tgd1975/tinyjukebox/src/tinyjukebox/web/web/help/images/box-back.jpg

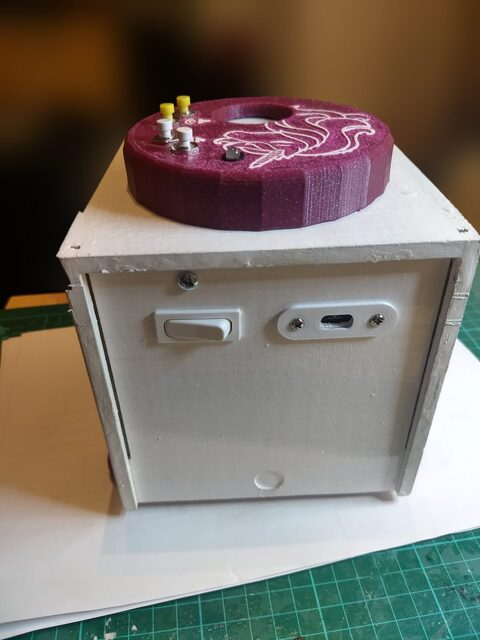
src/tinyjukebox/web/web/help/images/box-back.jpg
