tgd1975/tinyjukebox/hardware/3d-parts/figure_base_cup.png

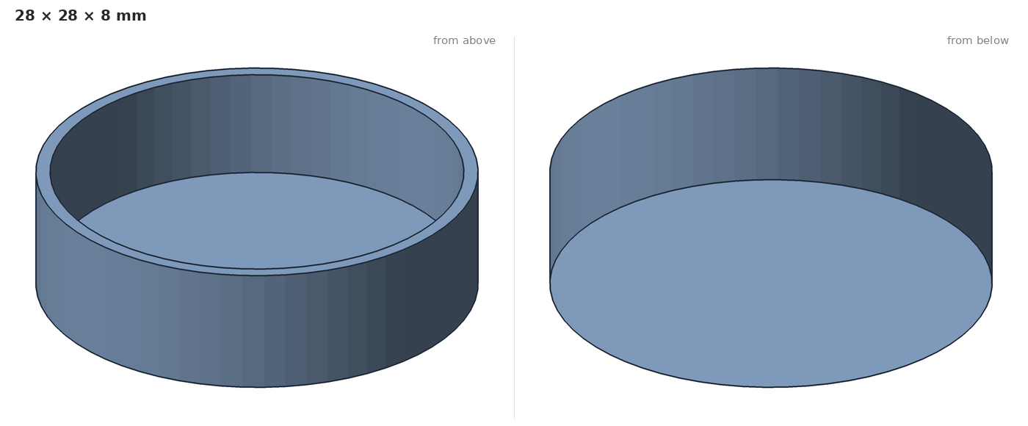
hardware/3d-parts/figure_base_cup.png
