tgd1975/tinyjukebox/hardware/3d-parts/figure_base_wide_plug.png

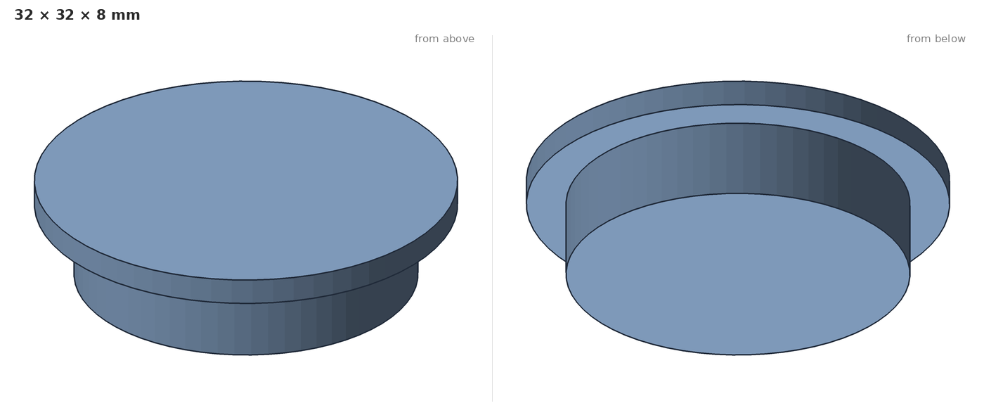
hardware/3d-parts/figure_base_wide_plug.png
