tgd1975/tinyjukebox/hardware/3d-parts/foot.png

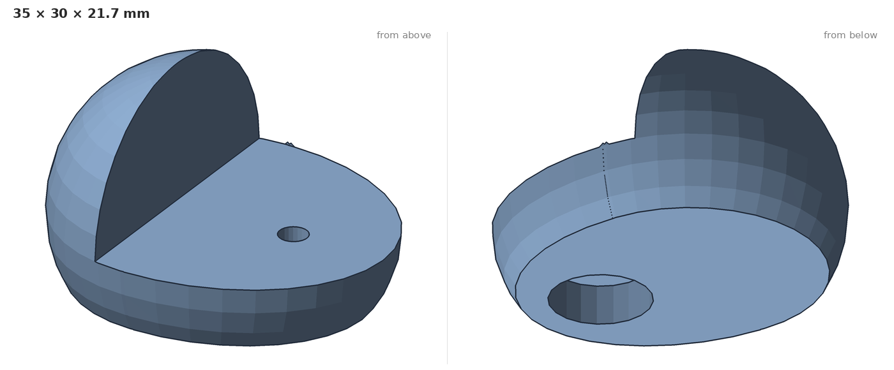
hardware/3d-parts/foot.png
