tgd1975/tinyjukebox/hardware/3d-parts/front_grille.png

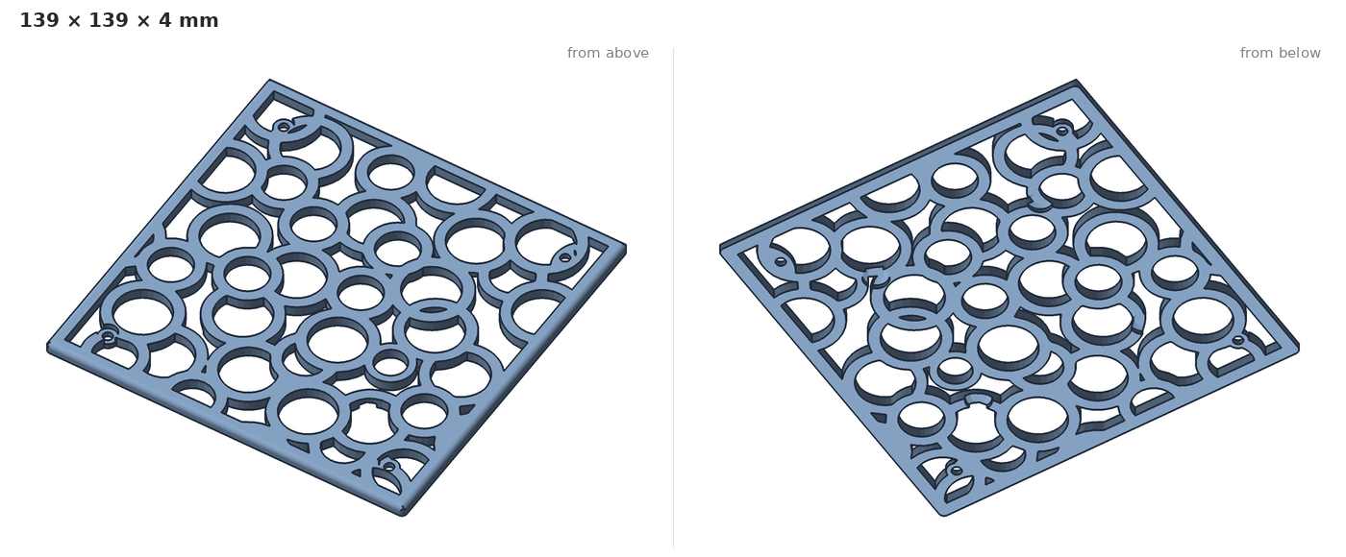
hardware/3d-parts/front_grille.png
