tgd1975/tinyjukebox/hardware/3d-parts/lid.png

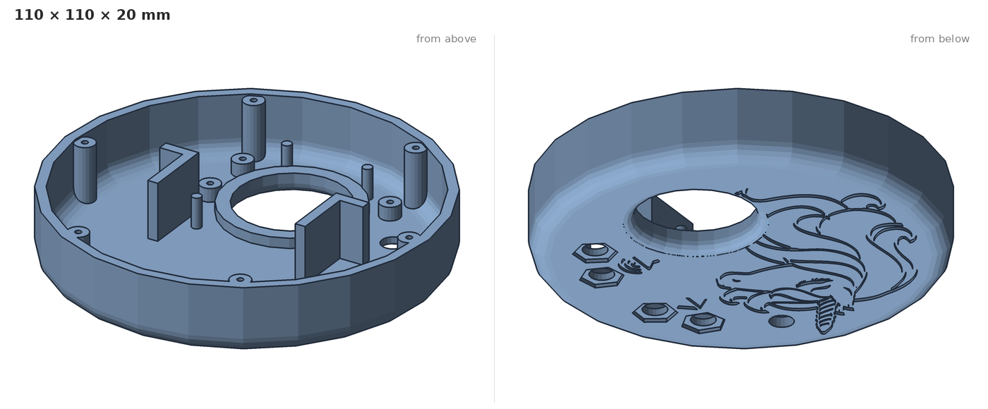
hardware/3d-parts/lid.png
