tgd1975/tinyjukebox/hardware/3d-parts/lid_inlay.png

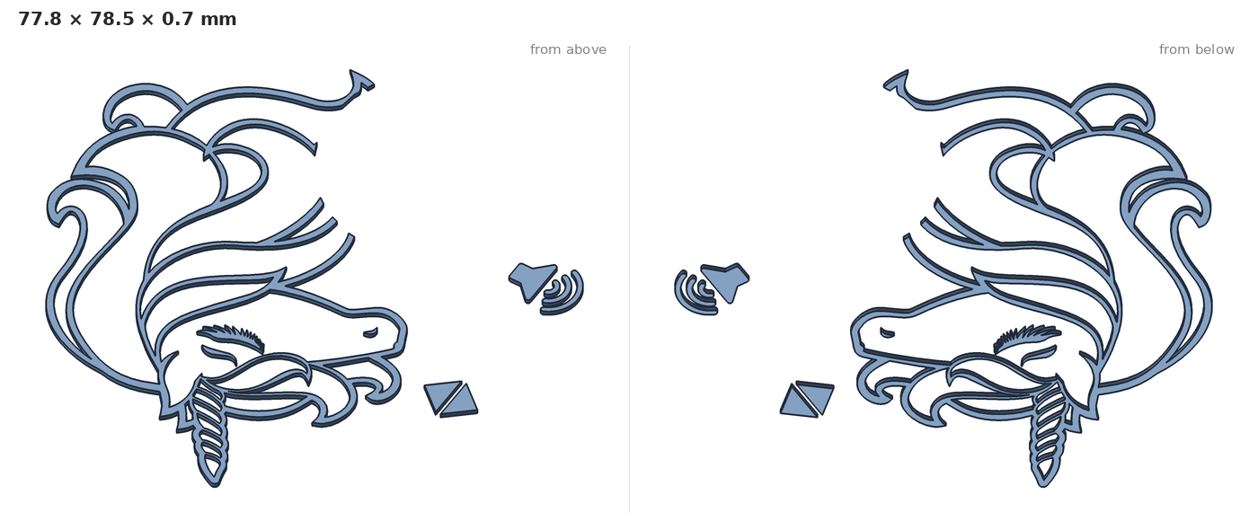
hardware/3d-parts/lid_inlay.png
