tgd1975/tinyjukebox/hardware/3d-parts/lock_screw_bracket.png

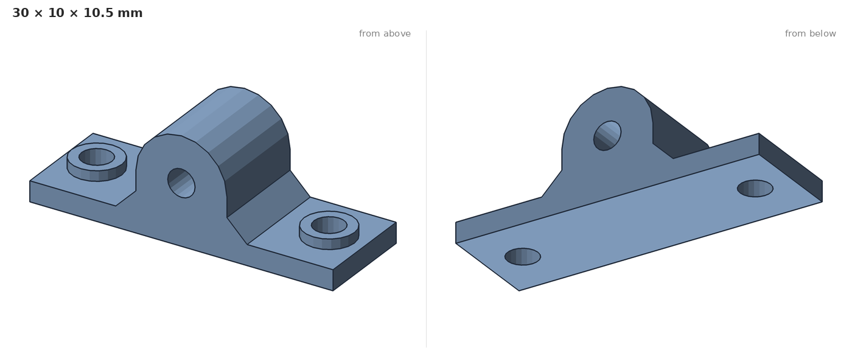
hardware/3d-parts/lock_screw_bracket.png
