tgd1975/tinyjukebox/hardware/3d-parts/power_bank_mount.png

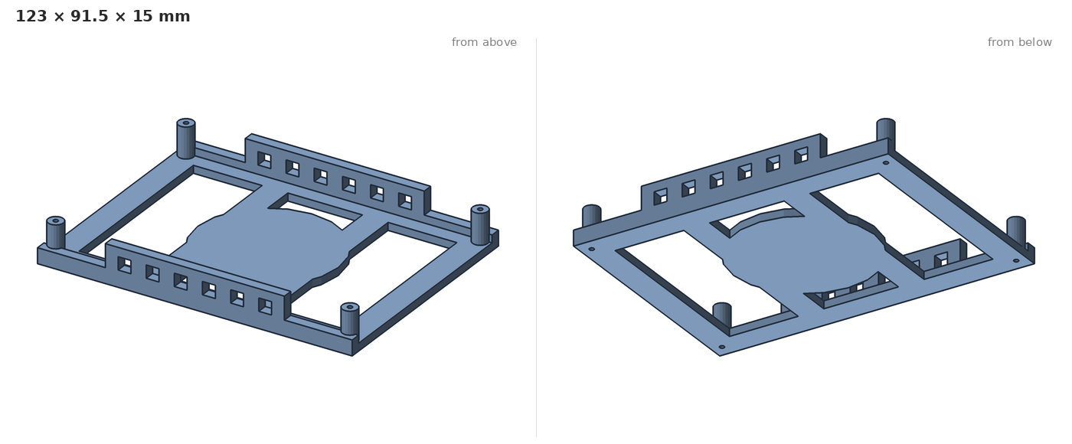
hardware/3d-parts/power_bank_mount.png
