tgd1975/tinyjukebox/hardware/3d-parts/rfid_reader_holder.png

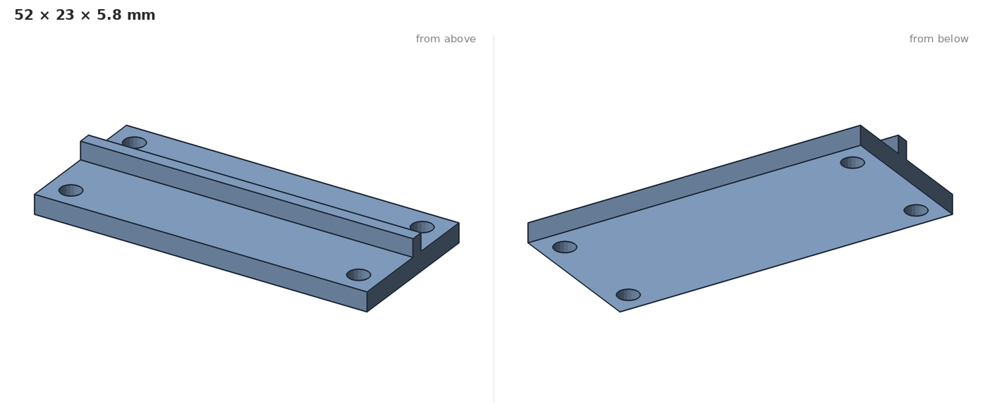
hardware/3d-parts/rfid_reader_holder.png
