tgd1975/tinyjukebox/hardware/3d-parts/spacer_3mm.png

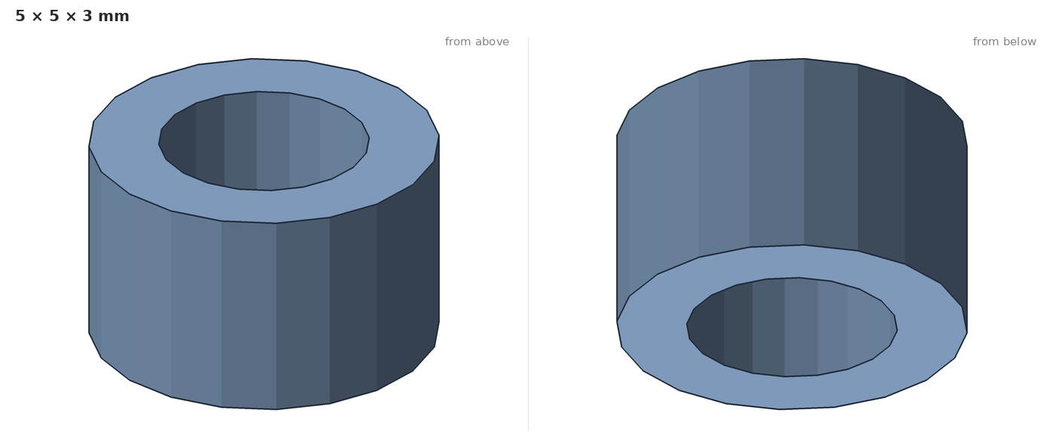
hardware/3d-parts/spacer_3mm.png
