tgd1975/tinyjukebox/hardware/3d-parts/usb_port_bezel.png

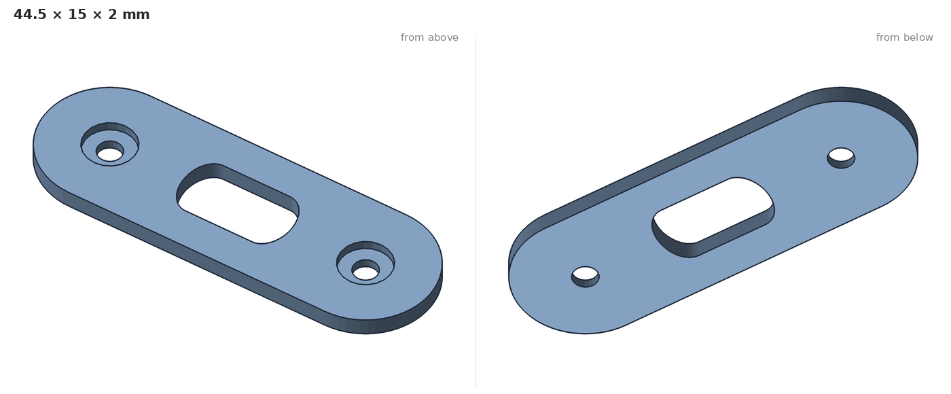
hardware/3d-parts/usb_port_bezel.png
