tgd1975/tinyjukebox/hardware/3d-parts/front_panel.stl

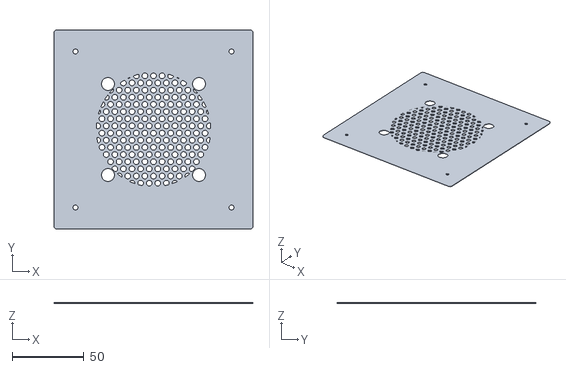
[picture p28: CAD file, 2026-10-13]
hardware/3d-parts/front_panel.stl
139.0 x 139.0 x 1.00
