tgd1975/tinyjukebox/hardware/3d-parts/rfid_reader_holder.stl

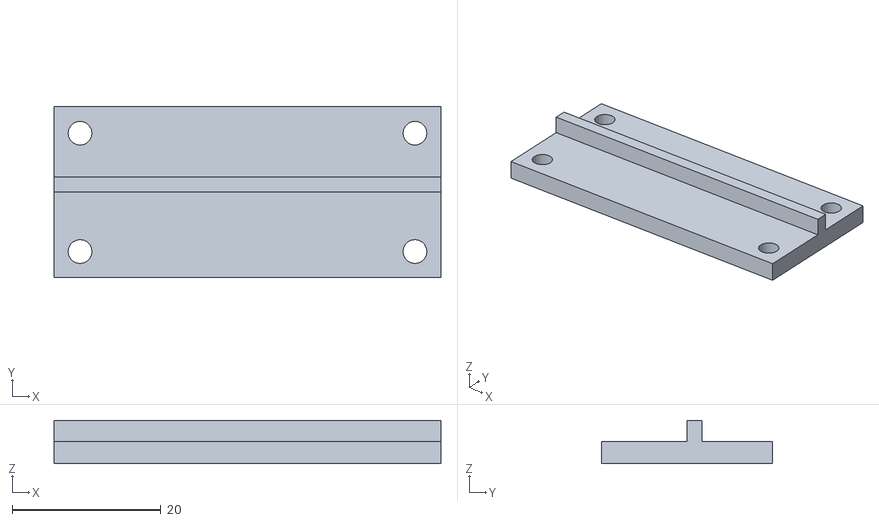
[picture p29: CAD file, 2026-10-13]
hardware/3d-parts/rfid_reader_holder.stl
52.0 x 23.0 x 5.80
