tgd1975/tinyjukebox/hardware/3d-parts/figure_base_wide_cup.stl

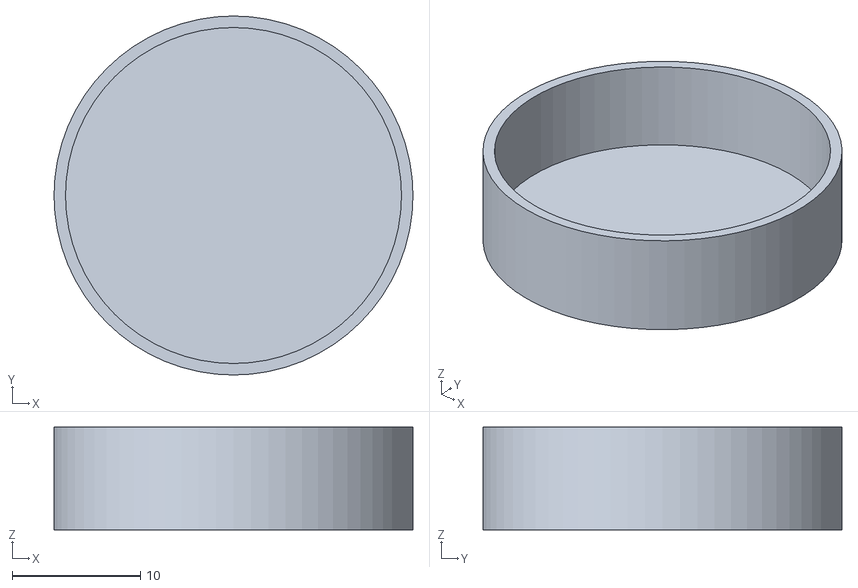
[picture p30: CAD file, 2026-10-13]
hardware/3d-parts/figure_base_wide_cup.stl
28.0 x 28.0 x 8.00
