tgd1975/tinyjukebox/hardware/3d-parts/usb_port_bezel.stl

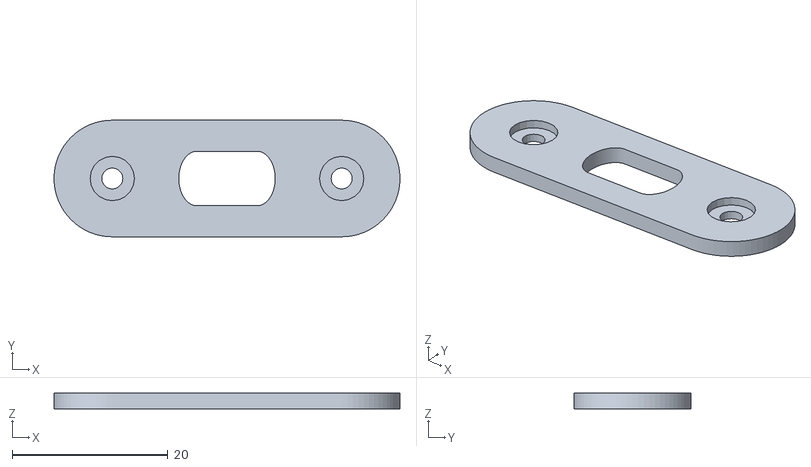
[picture p31: CAD file, 2026-10-13]
hardware/3d-parts/usb_port_bezel.stl
44.5 x 15.0 x 2.00
