tgd1975/tinyjukebox/hardware/3d-parts/front_grille.stl

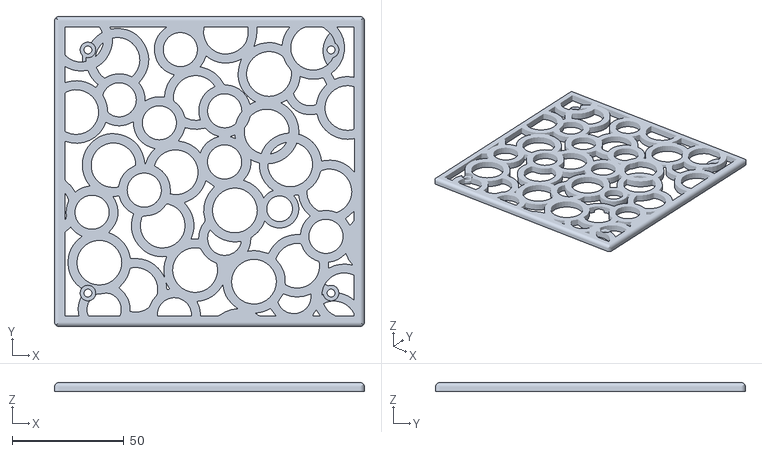
[picture p32: CAD file, 2026-10-13]
hardware/3d-parts/front_grille.stl
139.0 x 139.0 x 4.00
