tgd1975/tinyjukebox/hardware/3d-parts/power_bank_mount.stl

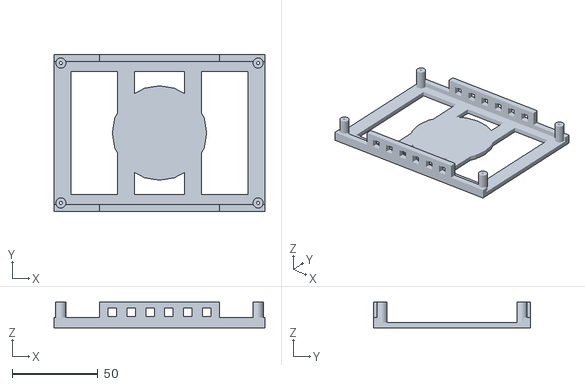
[picture p33: CAD file, 2026-10-13]
hardware/3d-parts/power_bank_mount.stl
123.0 x 91.5 x 15.0
