tgd1975/tinyjukebox/hardware/3d-parts/lid.stl

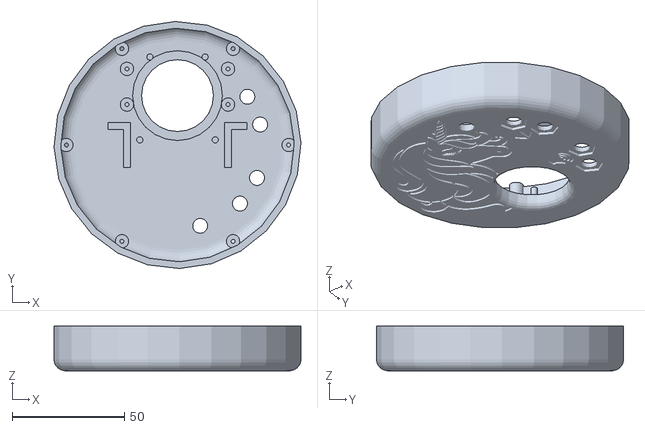
[picture p34: CAD file, 2026-10-13]
hardware/3d-parts/lid.stl
110.0 x 110.0 x 20.0
