tgd1975/tinyjukebox/hardware/3d-parts/figure_base_wide_plug.stl

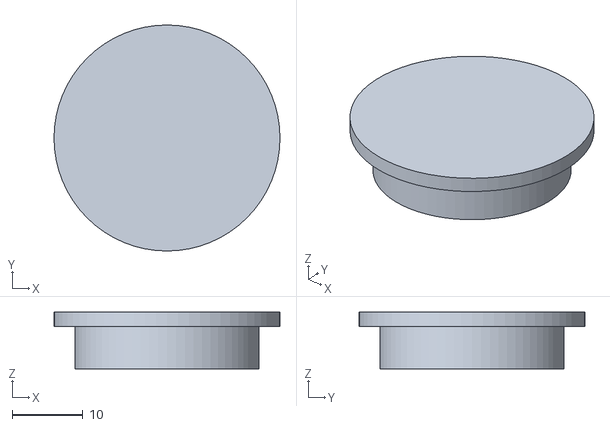
[picture p35: CAD file, 2026-10-13]
hardware/3d-parts/figure_base_wide_plug.stl
32.0 x 32.0 x 8.00
