tgd1975/tinyjukebox/hardware/3d-parts/lid_inlay.stl

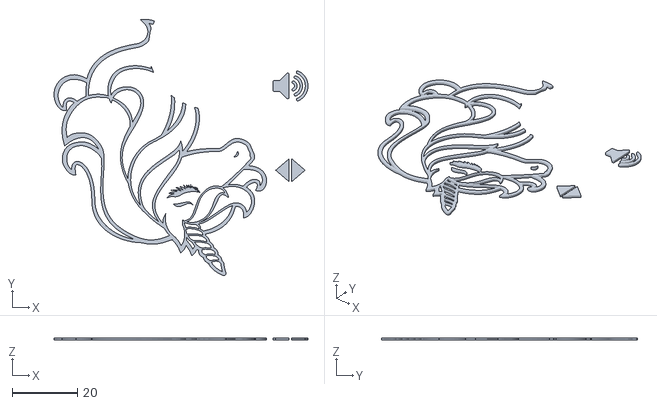
[picture p36: CAD file, 2026-10-13]
hardware/3d-parts/lid_inlay.stl
77.8 x 78.5 x 0.7
