tgd1975/tinyjukebox/hardware/3d-parts/spacer_3mm.stl

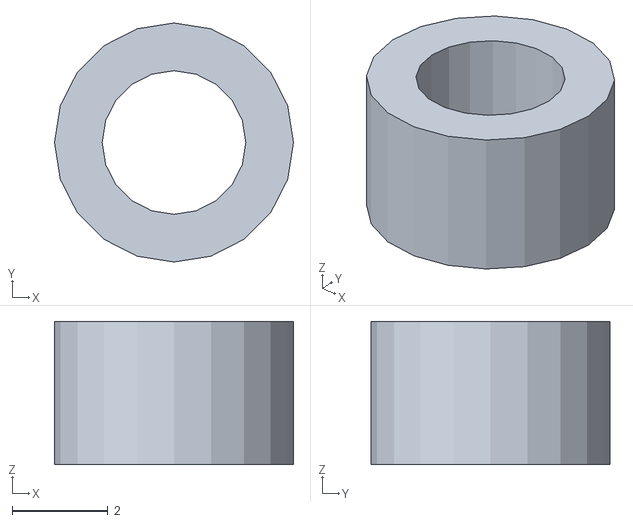
[picture p37: CAD file, 2026-10-13]
hardware/3d-parts/spacer_3mm.stl
5.00 x 5.00 x 3.00
