tgd1975/tinyjukebox/hardware/3d-parts/figure_base_plug.stl

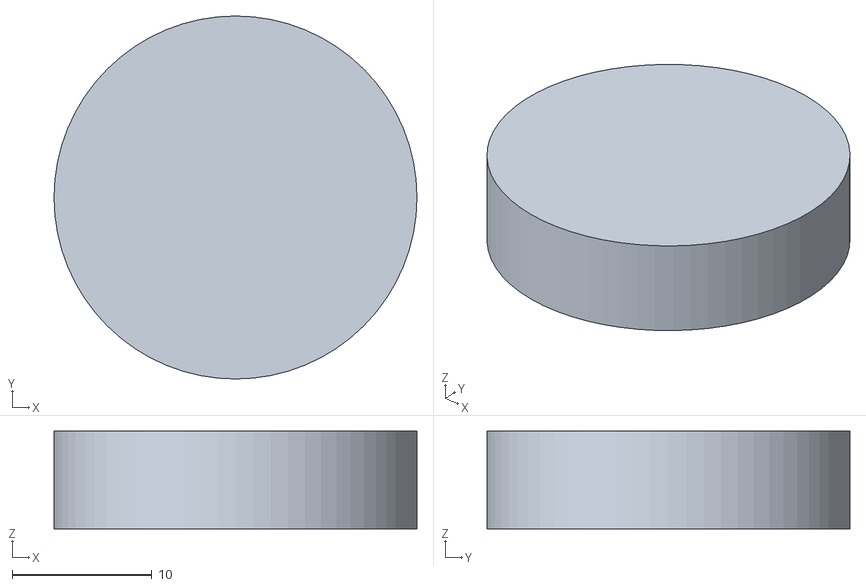
[picture p38: CAD file, 2026-10-13]
hardware/3d-parts/figure_base_plug.stl
26.0 x 26.0 x 7.00
