tgd1975/tinyjukebox/hardware/3d-parts/foot.stl

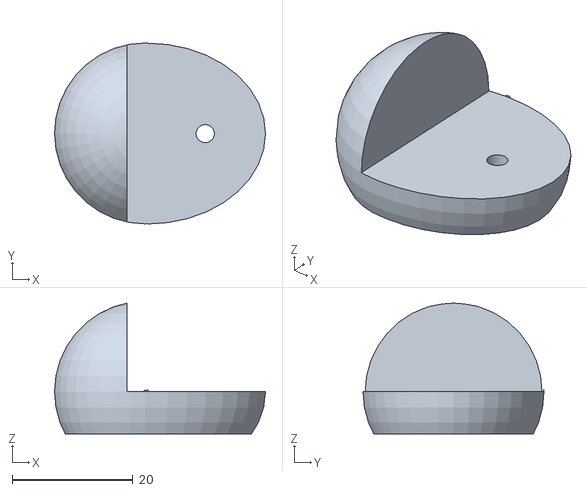
[picture p39: CAD file, 2026-10-13]
hardware/3d-parts/foot.stl
35.0 x 30.0 x 21.7
