tgd1975/tinyjukebox/hardware/3d-parts/lock_screw_bracket.stl

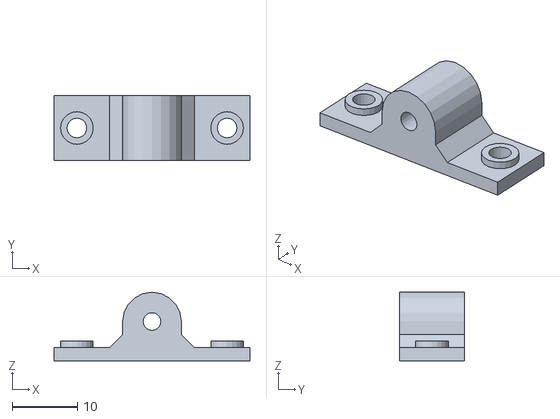
[picture p40: CAD file, 2026-10-13]
hardware/3d-parts/lock_screw_bracket.stl
30.0 x 10.0 x 10.5
