tgd1975/tinyjukebox/(list of files, cad)

Other CAD files:
hardware/3d-parts/figure_base_cup.stl
