tgd1975/tinyjukebox/docs/user/de/quick-guide.md

# Tiny Jukebox – Kurzanleitung

Tiny Jukebox

<!-- Textvorlage für eine Karte im Format A6 (wie die Tag-Karten), Vorder- und Rückseite.
     Bilder und Layout kommen dazu – der Text bleibt deshalb knapp. Ausführlich: manual.md -->

## 1. Vorderseite: Hören

### 1.1 Tag

- auflegen: Album spielt dort weiter, wo es aufgehört hat
- abnehmen: Stopp

### 1.2 Tasten

- lauter / leiser – halten: feine Schritte
- weiter: nächster Titel
- zurück: Titelanfang – in den ersten 10 s: voriger Titel
- zurück 1 s halten: Album von vorn

### 1.3 Licht

- grün: bereit
- blau: spielt – blinkt: Album zu Ende
- weiß/blau: Pause
- grün → türkis → blau: holt das Album, oder das Radio startet
- gelb: Tag ohne Album
- rot blinkend: Album defekt

### 1.4 Kopfhörer

- koppeln: Kopfhörer in den Pairing-Modus, dann weiter + zurück 5 s halten – blinkt blau, weiß = fertig
- danach: Kopfhörer einschalten genügt, Ton nur im Kopfhörer
- Kopfhörer aus: Pause – weiter drücken: Lautsprecher

### 1.5 Aus

- mit dem Schalter auf der Rückseite

### 1.6 Telefon (App)

- Tag an die Rückseite des Telefons: spielt wie auf der Box – oder eine Kachel antippen
- dasselbe Licht als Band oben am Bildschirm

## 2. Rückseite: Webseite

### 2.1 <https://tinyjukebox.local>

- im selben WLAN öffnen, Sicherheitswarnung bestätigen, „Deutsch“ wählen, anmelden

### 2.2 Tabs

- **Jetzt:** was läuft, Pause, Titel, Lautstärke
- **Tags:** Tag per Klick auflegen
- **Hochladen:** Titel des Albums eingeben, MP3-Dateien wählen → „Album anlegen“
- **Neuer Tag:** auflegen → „Jetzt“ → Album wählen → „Verknüpfen & abspielen“
- **Radio:** Sender anlegen, unter „Tag-Verwaltung“ einem Tag zuordnen
- **Spotify:** Link aus der Spotify-App einfügen, unter „Tag-Verwaltung“ einem Tag zuordnen
- **Bluetooth:** Kopfhörer koppeln, Akku, Höchstlautstärke
- **System:** Passwort, Benutzer, Bibliothek, Version
