tgd1975/tinyjukebox/(list of files, drawings)

Other design files:
hardware/circuits/tinyjukebox.fzz
