tgd1975/tinyjukebox/(commit log)

2026-10-13 Tiny Jukebox 0.30.0
    RFID-controlled music box for children: the software of the box and of the library, the playbook, the package for
    the NAS, the documentation and the hardware. CHANGELOG.md tells the history of the project up to this version.
    [figure_base_cup.stl, figure_base_plug.stl, figure_base_wide_cup.stl, figure_base_wide_plug.stl, foot.stl, front_grille.stl, front_panel.stl, lid.stl]
2026-10-13 The playbook sets up a new box with slots (0.30.1) - the role tinyjukebox enabled the service before the role slots had written its unit: a box that never had the service stopped at "Service starts w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
2026-10-13 The page of a box shows its name with "Rename" next to it (0.30.2) - tab "System", section "Library": the name of the box with a button that asks for the new name, starting from the one the box has -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
2026-10-13 The page of a box shows what its hardware does (0.31.0) - tab "System", card "Hardware", for admins: level of the pin, last event and number of presses of every button, pattern and lit lights of the 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
2026-10-13 The concept for Spotify is decided: the box as a speaker without a tag, a daily look for a new build - the box asks Spotify every day whether the build has changed, the page shows state and age of th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
2026-10-14 The concept for Spotify after its review: a new build only 30 days before the last day, an account of its own per box - Spotify publishes builds several times a day: the box keeps the build it has un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
2026-10-14 The library says why a box went back from a version (0.31.1) - the box sends the reason of its last switch away from a version it left along (health check failed: ...), and the library logs it, keeps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
2026-10-14 Every backup holds the covers of the albums (0.32.0) - the cover of an album is an image of the images folder, album-<8 characters>.<type>, named by the album in targets.json (cover) - no file of the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
2026-10-14 A backup is put back on the page (0.35.0) - tab "System", card "Backup", on a box and on the library: an upload, or a backup of the table, is read to its end and unpacked beside the data, the page as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
2026-10-14 Entries of Spotify in the catalog (step 1 of the concept) - the kind "spotify" in targets.json and tags.json: name, address spotify:<kind>:<id> and cover; made from the link that the Spotify app shar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
2026-10-14 The account of Spotify on a box (step 2 of the concept) - the Soloist API key, the login and the switch of the speaker stay in the folder "spotify" of the box: not synchronized, not in a backup - the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
2026-10-14 The box plays entries of Spotify (step 3 of the concept) - a tag of an entry plays it with Soloist, like an album: it continues at the saved track - reached by its place and checked by its address, l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
2026-10-14 The statistics count entries of Spotify (step 4 of the concept) - an entry counts like an album: per tag, per day, played to its end; the skipped tracks of an entry are counted by their address and s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
2026-10-14 Spotify in the documents, the concept is done (0.37.0, step 5 of the concept) - manuals and quick guides (de, en): section 7.6 "Spotify", the tab "Spotify", the filter in "Tags" - architecture.md: Pl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
2026-10-15 A new version is no longer sent back right after the box was switched on (0.36.1) - the start script counted the 120 s of stage 1 on the clock of the system, which jumps forward by hours when the Pi 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
2026-10-15 The box may restart its service without a password (0.36.1) - the slot scripts restart it with sudo systemctl restart tinyjukebox as the user of the box after a switch; the playbook allows this one c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
2026-10-15 The volume buttons keep working after a step that failed (0.36.2) - an exception while the volume was set left the state machine in the state of that step, which takes no button, until the next start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
2026-10-15 The concept for installing without the repository is reviewed against 0.37.1 and reworked - the installer does all that the playbook does today for a box with slots: also the packages for Spotify wit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
2026-10-16 A trigger file is obeyed once, and Spotify can be connected, on a box whose user needs a password for sudo (0.37.2) - the start script removes a trigger file on the boot partition with sudo as the us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
2026-10-16 The installer of a box, and the playbook runs it (steps 1 and 2 of the distribution concept) - deploy/install/install.sh sets up a fresh Raspberry Pi OS Lite: packages (with those for Spotify), group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
2026-10-16 The library hands out the installer and a new box joins it with one line (step 3 of the distribution concept) - the library fetches install.sh with every release (tinyjukebox-install-<version>.sh in 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
2026-10-16 Library and box start with nothing but a folder (step 4 of the distribution concept) - tinyjukebox-library --data DIR and tinyjukebox --data DIR: everything below the folder, in the folders library a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
2026-10-16 The Docker image and PyPI (steps 5 and 6 of the distribution concept) - deploy/docker: one image for the library (default) and a box without hardware (command box), built from the wheel of the build,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
2026-10-16 The installer passes on the stand-in for a box - deploy/install/test/run.sh: the stand-in has the package source of Raspberry Pi OS (liblgpio1 is only there; its key from raspberrypi-archive-keyring,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
2026-10-16 Keep the wires from the lid away from the magnet ring of the speaker - hardware/README.md, section Wiring
2026-10-16 Photos of the box and a logo in the documents - docs/images/ holds photos of the first box (December 2019) and of the box today, the Tinkercad model and the logo as SVG
    - README: the logo in place of the title, light or dark by the mode of the page; the box today under the first
    paragraph; in "History" the first box of 2019 and the inside then and now
    - hardware/README.md: the model at the top, the wired lid next to the circuit, the bare case above the printed parts,
    a photo for each printed part that has one
    - box.md: the inside today in section 1; in section 11 the connectors secured on the pins of the Pi
    - docs/hardware/README.md: the Pi with the Audio Amp SHIM
    - manual (English and G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
2026-10-19 Recovery concept: power cut is how the box is switched off; cause of the journal damage
2026-10-19 Box config: 2 s aplay buffer against radio pauses on WLAN with power saving
2026-10-19 Fallback slot is recovery mode: install a version instead of an old application
    The start script no longer starts the application of the fallback slot,
    which could not read the data of today. It installs the newest version the
    box has not gone back from and restarts into it; without one it waits and
    asks again every 10 minutes, without a restart loop. With updates by hand
    or off it waits for an administrator. The page button becomes "Start
    emergency mode"; texts for the data left out.
2026-10-19 Release 0.40.0: recovery mode and tolerant data, documented
    Section 4.21 (damaged and unknown data), journal marks in section 7, the
    fallback slot as recovery mode in section 6.10, user manuals. The recovery
    concept is implemented and removed.
2026-10-19 Central diagnostics: the library keeps what the boxes log
    A log handler collects warnings, errors and marked structured events,
    redacted and bounded, and the synchronization delivers them; the library
    keeps them in diagnostics.sqlite with retention and shows them in its Log
    tab with filters, copy and export. A box that cannot start reports why
    through its start script over the stable PUT /api/sync/startup. Radio
    connections are measured phase by phase (playlist, ffmpeg and aplay, first
    audio, estimated audible start, underruns).
2026-10-19 App, step 0: the probe - how a tag behaves on a phone
    A throw-away app (app/probe/, not released) with one screen and a log, no library, no sound: the UID in the form of
    rfid-reader and when a tag is found, how long it is kept, how late a removal is reported - NfcAdapter.ignore()
    against asking the tag every 250 ms, switched with a button -, what happens when the screen goes off and on or the
    app leaves the screen, the battery every minute while the screen is kept on and dimmed after 30 s. The log is shared
    as text. Built with ./gradlew -p app :probe:assembleDebug, installed with adb install.
2026-10-19 App, steps 3 and 4: simple mode plays, expert mode shows the page
    Simple mode (the phone as a box):
    - pairing with the camera (ZXing, no services of Google needed); a debug build also takes the content of the QR
    code from the intent, for the emulator
    - the jukebox: the states of STMOperation that apply, the band of colour as the LED of the box; a tag plays its
    album from the saved position or its station, another tag replaces it, taken away the position is saved, an album
    played to its end blinks blue and starts from the beginning next time, an unknown tag is looked up and reported
    not linked, an album that is not in the cache is loaded, a missing next track is waited for
    - Media3/Ex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
2026-10-19 App, step 5: delivery - the APK in every release, the library hands it out at /app.apk
    - scripts/build_app.sh builds dist/tinyjukebox-app-<version>.apk, signed with APP_SIGNING_KEY (keystore in Base64)
    and APP_SIGNING_PASSWORD; without them with the debug key. build.sh runs it, the release job sets up Java and
    needs the job "app"; app/ counts as software in release_needed.sh
    - the library fetches the APK with the slot and the installer of a release; the package brings the one of its
    version; GET /app.apk (no login) hands out the app of the version that "Add a box" installs
    - the overview names it ("app"), the tab "Boxes" shows its link and QR code; /api/sync/interface names it too,
    s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
2026-10-19 App, step 6: a tag of Spotify plays on the phone in its Spotify app
    - SpotifyPlayer steers the Spotify app with Spotify's App Remote SDK, as a box plays an entry with Soloist: shuffle
    and repeat off, the saved place of the track and the second (from the beginning if the track there is another
    one), the buttons, the position with track-uri, track lines with uri and title, the end when Spotify plays
    something else by itself; the volume limit is held by setting the volume of the phone back
    - the SDK (Apache-2.0) is no package of Maven Central: the build file fetches it from Spotify's release on GitHub and
    checks its SHA-256; Gson from Maven Central
    - the library: PUT /api/library/spotif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
2026-10-19 The app gets a document of its own: docs/developer/app.md, as the box and the library have
    library.md, section 5.2 moves to app.md (sections 1 to 10); library.md keeps a short section 5.2 that points
    there. All references - code comments, rest-api.md, development.md, roadmap.md, the concept, README.md - name
    app.md; README.md lists it among the documents.
    [Main.kt]
2026-10-19 Release 0.43.0: underruns of aplay are counted in any language
    aplay prints its underrun message in the language of the system (German:
    "Unterlauf!!! (mindestens 2844,463 ms)", tried with aplay 1.2.15 on the PC,
    also with -q); the pattern matches its form and a decimal comma.
2026-10-19 The concept of the app is closed: its open points are the to-do list of app.md, section 10
    The probe's questions, deciding presence or touch, trying Spotify with the registration, the key of the app (0.42.0
    was signed with the debug key), the tries on a real phone, and updates by hand to be looked at again. The decisions
    of the concept stay in the git history.
2026-10-19 Release 0.44.0: the LED shows that a radio station is getting ready
    From placing the tag until the sound is heard, the LED flows green, aqua,
    blue (as while an album is fetched); blue only once aplay plays. The radio
    is PLAYING only from then on: AudioPipeline calls on_heard when ffmpeg has
    delivered as much audio as aplay's buffer holds - aplay starts when it is
    full. radio.startup records audible_ms measured instead of an estimate.
    The buffer of the configuration (ms) was read as seconds by the radio
    player: audible_ms_estimated and buffer_ms of 0.41.0-0.43.0 were 1000
    times too large.
    [rgbled.py]
2026-10-19 The concept of the radio startup is closed: its open points are in roadmap.md, section 2
    The measurement and the LED are implemented (0.41.0, 0.44.0) and documented
    in library.md 4.22; what remains - measuring real stations, agreeing a
    target, choosing the fix - is a row of the open measurements.
2026-11-01 TODO.md: was nur der Besitzer tun kann, aus der projektübergreifenden Liste ~/Dokumente/Projekte/TODO.md hierher (die gibt es nicht mehr)
2026-11-03 Review: a lost headset hands the output to the speaker only once the playback has paused
    - Headset: until the playback has handled the loss of the headset, the output stays on the headset that has gone, so
    that what was queued before - a track that was due, a button - fails there and pauses instead of playing on the
    speaker. The playback calls back when it is done (cmd_output_lost(then)), at the latest after 3 s; a headset that
    comes back meanwhile keeps the output.
    - SafeMachine.call_soon: a function called in the worker after the events queued before it.
    - STMPlayAlbum: the loss of the headset while the box waits for a file from the library pauses as well.
    - A listener of unexpected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
2026-11-03 Review: a file that broke off on its way is continued where it stopped
    The library answered the request for the rest of a file with 200 and the range, and the box took only 206 for "the
    rest": a continued download overwrote the beginning of the file with its end, a complete file waiting for its rename
    became empty, and every interruption cost a try and a warning "wrong checksum". The library answers 206 now; the box
    continues a file whenever the answer begins where it stopped - also with a library before this version, and with a
    file that is complete already (200 with an empty range, which curl and older boxes take as they did).
    Claude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
2026-11-03 Review: the library goes on after what it did not expect, and keeps devices apart
    - The thread that looks for releases ends no more on an answer that is no release (a page of a proxy, a missing
    field) or on a full disk; the archive copes with a file removed by hand.
    - A version removed from the archive is fetched again one at a time, and never for a request without credentials
    (the installer of a new box gets what the archive has).
    - Whether the clock of a computer was set from the network is asked from the kernel as systemd does it - also for
    chrony, ntpd and the Docker image; the statistics of a box without timesyncd counted no days before.
    - A box cannot take itself over (it removed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
2026-11-03 Review: bluetooth addresses redacted as such, one rule for user names, passwords from files
    - What a box sends of its log names a bluetooth address <mac>, no more <uid>; a UID and a longer run of hex bytes are
    never cut in two.
    - tinyjukebox-users takes the names the page takes: no blanks around them, no ":", at most 64 characters, nothing
    that cannot be printed.
    - A password generated at the first start with one folder is printed once on the error output (docker logs) and no
    more written to the log file, which the page and the library show.
    - TINYJUKEBOX_ADMIN_PASSWORD_FILE and TINYJUKEBOX_BOOTSTRAP_PASSWORD_FILE: the password from a file, a secret of
    Docker - the environment of the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
2026-11-03 Review: the box stops completely, and nothing acts after its owner has stopped
    - An album survives a card that cannot be written: a position that cannot be saved is logged once, the album plays
    on, and stop() ends the machine and its threads also when END raised. A track that cannot be started after the
    start of the album pauses it; at the start the album is shown as broken, as before.
    - The stop of the box takes every step, also after one that failed, and raises the first error afterwards; stop()
    of a service disconnects its queue and counts as stopped also then.
    - The player resets its state when a track cannot be started; the pipeline of a track is exchanged under a lock.
    - The blue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
    [bluetooth.py, fakes.py, input.py]
2026-11-03 Review: the page keeps no token, shows QR codes as images and counts a restore upload as activity
    - Sending a backup to be restored counts as something the user does: an upload longer than the idle timeout no
    longer logs the page out before the question "restore?".
    - The QR codes of the library are images (a data URL) instead of markup put into the page; the library sends them as
    SVG documents of their own, with their namespace.
    - The page drops the token of the login answer; the cookie carries the session.
    - A tab name is looked up among the own keys only (#__proto__ led to an error instead of the first tab).
    - A size that is not known is said as such instead of breaking the version car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
2026-11-03 sync: damaged files, journal gaps, resumed downloads and a full phone no longer stop the app
    The sync module of the app mirrors tinyjukebox.sync where the review found it
    behind (findings H1, M1, M3, L1, L2, L4, L7):
    - A line of the outbox or the journal that cannot be read (half written when the
    app was ended, zeros, a full storage) is left out, counted, logged and the file
    is written anew (_lines of sync/data.py). A journal number without its line
    becomes a recovery_gap line on start (_load_journal); a copy file that cannot
    be read is delivered again. appendLine starts a new line after a line that was
    cut off, so that the next one is not lost with it; writeAtomic throws an
    IOE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
2026-11-03 sync: an album that was taken over may begin at once
    The takeover of an album whose files changed in the library runs on the
    thread that loads it (need(renew = true)). It now announces the album as
    soon as it is done, so that the jukebox begins when the track that is due
    is here - as before, when the takeover ran on the thread of the player -
    and the files that changed are loaded while it plays. CacheTest covers the
    takeover against a stand-in library.
    Claude-Session: https://claude.ai/code/session_01UtNraW8oMEinTkc3e93mv8
2026-11-03 app: no crash when swiped away, a full storage or a bad answer; other apps press buttons only
    Findings M2, M4, L1, L3, L4, L5, L6 and the app part of H1 of the review.
    The Android module cannot be built here (no SDK, no Google Maven): it uses
    only APIs that the files used before or that Media3 1.8 has, and must be
    built and tried on a phone or in the emulator.
    - PlaybackService.onTaskRemoved asked the player on the main thread, while
    it belongs to the thread of the jukebox: Media3 threw and the process died
    when the app was swiped away during an album. It asks Jukebox.active()
    now, what the jukebox published last: something plays, is loaded or waits
    for its next track.
    - The media s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
2026-11-03 rfid driver: watchdog for rfid-reader, reading that never blocks, errors published, pins checked
    - The thread reads the pipe itself (selectors with a timeout of 0.1 s, its own line splitting) instead of iterating
    over it: a stop ends the thread at once, also while an rfid-reader left behind by a killed sudo keeps the pipe
    open. The thread closes its end, so that reader ends by itself (it polls stdout for POLLERR).
    - The thread ends rfid-reader in a finally (close the pipe, SIGTERM, SIGKILL after stop_timeout, wait): an exception
    while a line is processed (e.g. a publication after the queue was disconnected) leaves no zombie, and healthy()
    is false whenever rfid-reader does not run.
    -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
    [fakes.py, rfid.py, test_rfid.py]
2026-11-03 rfid-reader: uid read with every check, halt before the second check, alive; stub with tag states and the macros
    Read loop (main.cpp):
    - The uid is read with every check (select after every WUPA). Of two stacked tags the select picks one; when that one
    is lifted, the other one is reported now, and so is a quick swap. Another uid counts after a second look 100 ms
    later, like a removal (after no answer at all any other uid counts: the old tag has missed twice). A uid that
    cannot be read changes nothing.
    - After a check without an answer PICC_HaltA comes before the second check: a garbled answer leaves the tag READY,
    and a READY tag ignores the next WUPA - "removed" and "tag" again, the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
    [MFRC522.h, main.cpp]
2026-11-03 rfid driver: an error alone is no message - a tag placed on the web page outlives a restart of rfid-reader
    STMOperation takes every RfidState with the uid None for "no tag". Published with every change of the error, a
    crash, a stall or a new start of rfid-reader ended the album of a tag placed on the web page. The state is published
    when the uid changes, with the error of that moment; the current error is in the state of the driver (error,
    changed_at), which the page shows.
    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
    [rfid.py, test_rfid.py]
2026-11-03 Review: every wait for aplay, PipeWire and Soloist is bounded; a download of Soloist is unpacked in pieces
    - PipeReader ends aplay with SIGTERM first and closes its input only then: closed first, the input was flushed into
    a pipe that an aplay hung in its driver never empties, and restart_output(), silence() and close() waited for
    it - from the handlers of the headset and from the worker of STMOperation. The input is unbuffered, every wait is
    bounded (2 s after SIGTERM, 2 s after SIGKILL); a process that does not end even then is left behind and logged.
    close() ends aplay before it waits for the reader, which may wait in a write.
    - The reader starts no aplay while it is muted, and an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
2026-11-03 Review: Spotify never waits in the dispatch thread, retries in a loop and runs no Soloist while "Connect" runs
    - The commands of the Spotify speaker - the buttons of the box, the headset, the page - only queue: SpotifyEngine runs
    soloist ctl and ends aplay in a thread of its own (Spotify.commands), one after the other; before, every button
    spawned soloist ctl in the dispatch thread, up to 10 s with a hung Soloist. A lost headset mutes the sound at once,
    the phone's playback is paused in that thread after what was queued before, and only then "then" hands the output
    to the speaker; a headset that came before a loss does not make the box heard again.
    - PlaySpotify decides about another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
2026-11-03 Slot scripts: notes that survive a power cut, the confirmed version for a link to nothing, no refusal without a key
    The start script and tinyjukebox-slot (deploy/slot), docs/developer/library.md, sections 6 and 9:
    - A note in state/ is written to a new file and renamed (note); trigger, switch and the link current are synced
    before the switch goes on. Every read is checked: an empty or damaged trigger, switch, update, active, check or
    failures counts as none - an empty state/update is "automatic", an empty note of a switch starts it anew. The
    newest version is replaced in state/slots in one step instead of appended. point_to and slot_set refuse an empty
    slot.
    - current points to nothi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
2026-11-03 rfid-reader runs as root only through a launcher of root that checks the program of the slot
    The sudoers rule allowed /usr/local/bin/rfid-reader, a link to current/bin/rfid-reader - and current, slots/ and every
    slot belong to the user of the service: anything that runs as that user could replace the program or repoint current
    and run it as root.
    - deploy/install/rfid-reader-launcher, installed by the installer as /usr/local/lib/tinyjukebox/rfid-reader with its
    paths written in (sudo resets the environment). /usr/local/bin/rfid-reader links to it; the rule keeps the path.
    It copies bin/rfid-reader of the active slot into /run/tinyjukebox-rfid (root, 0700; dd iflag=nofollow, less than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
2026-11-03 Release pipeline: the key stays out of the build container, branches sign with keys of their run, publish apart
    M2, scripts/build_slot_aarch64.sh: the container builds the folder of the slot only (build_slot.sh --unpacked) and
    never sees the key of the releases - code of others runs in it. uv in the container is 0.13.7, fetched from its
    release and checked against its sha256 (71279f8d...57dc) instead of astral.sh/uv/install.sh. The folder is signed,
    packed with GNU tar and described outside (build_slot.sh --pack); --unpacked leaves it for the workflow.
    M3, .github/workflows/ci.yml:
    - job build on every push, contents: read only. scripts/ci/build.sh runs as four steps - slot (no key), sign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
2026-11-03 Scripts on the PC send passwords and tokens only to a public key they know
    M4: update_library.sh sent the password and the code of DSM with curl -k, scripts/check_release.sh the token for
    scripts. scripts/trust.sh, sourced by both and by release.sh, gives curl the options for a server with a certificate
    of its own: the first time it shows subject, end, SHA-256 fingerprint and public key and asks (only in a terminal -
    without one nothing is sent), keeps the accepted key in ~/.config/tinyjukebox/pins (mode 600) and uses
    -k --pinnedpubkey from then on. --pin sha256//... gives the key, --cacert FILE an authority. A key that changed is
    refused (status 90) with the reason and what to do.
    - update_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
2026-11-03 Package for the NAS: any bootstrap password, and a pid file that names another program
    - deploy/synology/scripts/postinst wrote the bootstrap password with sed into "@BOOTSTRAP@" of library.yaml: the
    characters | & \ and " broke it. The Python of the package (/var/packages/python312/target/bin/python3, as
    start-stop-status uses it) writes it with the YAML library of the package - a double-quoted scalar on one line,
    escaped where needed -, checks that it reads back the same, and the file is written with umask 077 and then
    renamed. A failure is shown in the Package Center, as for the user admin. The password comes from the
    environment, never as an argument.
    - deploy/synology/scripts/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
2026-11-03 Docker: the passwords as secrets of compose, the base image pinned, the dependencies with their checksums
    - deploy/docker/compose.yaml kept both passwords in the environment of the containers for their whole life (docker
    inspect, every process inside), although they count at the first start only. They are now file secrets of
    compose, admin-password and bootstrap-password next to compose.yaml (deploy/docker/.gitignore), mounted below
    /run/secrets and named by TINYJUKEBOX_ADMIN_PASSWORD_FILE and TINYJUKEBOX_BOOTSTRAP_PASSWORD_FILE. The application
    reads these variables once the Python side supports them (not part of this commit). example.env only names a
    version; README.md, library.m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
2026-11-03 rfid-reader.trusted names program and version, not the slot; operations.md for the new behaviour
    - The installer lists each program of rfid-reader once, with its version, whichever slot holds it: the move of
    slots/next into its slot at the first start no longer changes the list, and a second run of the installer -
    deploy/install/test/run.sh checks it - says "Nothing changed".
    - slot_set writes a number of starts in any case: status --json reads it with tonumber.
    - operations.md: the slot commands run as pi, never with sudo; the reader checked by hand goes through the launcher;
    the symptom "rfid-reader: not started" and what to do. box.md section 11: the notes of the slot scripts and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
2026-11-03 Integration: the install line pins the library for the installer too; a refusal of the launcher is logged once
    - The line of "Add a box" passes --pin to the installer as well, so the first version comes from exactly this
    library (deploy/install/install.sh takes --pin since this version).
    - A message of rfid-reader, of its launcher or of sudo that comes with every start - e.g. the launcher refuses the
    program of the slot - is a warning once, and news again once rfid-reader has worked.
    - The build of the slot pins uv 0.13.6 (of 2026-10-26, checksum as published) instead of 0.13.7, released the day of
    this change.
    - configuration.md 1: the variables *_FILE and the generated password on th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
2026-11-03 Release 0.45.0: what the review of 0.44.0 found, corrected
    CHANGELOG.md: the section of 0.45.0. roadmap.md 1: what has to be tried on the box, with the app and with Spotify
    for the corrections of this version. TODO.md: what only the owner can do - the version, the environment "release"
    on GitHub, the installer on the box, the checks on box and phone, the keys of DSM and library, the files of compose,
    the test bed of the slot scripts.
    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
2026-11-03 What the review of the documentation found in the code, corrected
    - A new password ends the sessions of that user also when it is set with tinyjukebox-users passwd: a session
    remembers a fingerprint of the password it began with. The page keeps the session of the one who set it. The
    command no longer removes the last admin or makes them a user.
    - The library takes a bootstrap password of its config again when the config names another one than at the start
    before - the dialog of a new installation over the old data, a changed secret of Docker. One set on the page stays
    until then; a library of before 0.45 keeps the one it has.
    - "back" after the end of an album plays the last track ag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
2026-11-03 User documents checked against the code and the page; a page opened again keeps its login
    - Manuals and quick guides (de, en): emergency mode ends with `tinyjukebox-slot update --now` or `use a|b`; the LED
    of a tag of Spotify (red blinking: key, player or login missing; aqua: connecting); what only admins see, what a
    user may do in section 7; the app reads tags too; holding "back" works only in the app; a second box needs a
    hostname of its own; covers instead of cards; the title of an album before the upload; the reason of a radio
    break is in the tooltip of the badge; the power bank and the switch; red and magenta told apart; the two logout
    rules related; "place" for a tag througho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
2026-11-03 Developer documents of the box, the REST API and the app checked against the code
    - architecture.md: the STMPlayAlbum diagram regenerated (FINISHED -> REWIND on PREV); messages of PlaySpotify, the
    speaker state and the virtual headset; missing threads and timeouts; buffer-time sets the buffer (2000 ms on the
    box); start and stop sequences with backups and Spotify; the radio test only while no tag is on the box; the rule
    of BOTH_BUTTONS_WINDOW; OUTPUT_LOST in DELAY; the LED of a Spotify error; LocalQueue discards what is not delivered
    at a disconnect; the latency chain starts at published_at(); every tag ends the Spotify speaker.
    - drivers.md, rfid-reader.md: /usr/local/bin/rfid-reade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
2026-11-03 Library, operations, deployment, development and configuration documents checked against the code
    - library.md: the token rule in one place (section 8.2) - the package on the NAS needs a token, or an empty token
    file, also for a public repository; recovery mode ends with update --now or use a|b; reinstalling from nothing
    removes var/data too, and where the bootstrap password comes from (4.14, with the case of data of before 0.45);
    revert goes to the other slot whatever it holds; the proof of the health check and what stage 1 checks; release
    contents with the app and SHA256SUMS, app/ counts as software; "a box alone" with its own backups, releases and
    journal; a new certificate need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
2026-11-03 German user documents: the LED colour is "türkis" again throughout, not "aqua"
    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
2026-11-04 Add a style guide: docs/style-guide/
    Name, logo and its use, colours of the brand, the web page (light, dark,
    the colour of a box) and the LED, type, shapes, controls, pictures and
    the way the documents are written - taken from the logo SVGs, style.css,
    the app and messages.py. Three colour charts as SVG. Section 9 lists where
    the repository disagrees with itself: two accents (berry and coral), two
    sets of LED colours, and the contrast of the light theme.
    Documentation only: no release.
    Claude-Session: https://claude.ai/code/session_01UtNraZLVPtaoUEHrRueyzj
2026-11-04 Web page in the colours of the logo, contrast AA everywhere (0.46.0)
    - accent berry (#8e2f66, dark #d77aae) instead of coral, as logo,
    favicon and app
    - light theme: muted, ok, warn, error darker - every pair of text and
    ground reaches 4.5 : 1 (was down to 3.20 : 1)
    - colour of a box: oklch(.49 .15 hue) / soft .95 - at least 4.6 : 1 over
    all hues (was 3.98 : 1 around cyan)
    - --error-text: the error toast is readable in the dark theme
    - LED_COLORS of the page = the colours of the app (Jukebox.kt)
    - style guide: section 9 records the decisions
    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
2026-11-04 Page and documents follow the style guide (0.46.0)
    Page:
    - links in --accent; focus ring of the page on links and on everything with a tabindex
    - hover keeps the contrast: a tab under the mouse is --text on --surface-2, a tag card gets a frame
    (grey text on --border was 4.38 : 1)
    - dark --muted #a8a095: 4.65 : 1 on --warn-soft and 4.79 on --ok-soft (was 4.34 and 4.46)
    - the lid next to "Tiny Jukebox" has the colours of the logo on the page of the library, also dark
    - --backdrop token; an unknown LED colour shows as --muted instead of #888
    - the tip of the LED names its colours in the language of the page
    - German: "Album von vorn", "Titel von vorn"
    Documents:
    - every section numbered (REA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
2026-11-04 Concept: the documentation as a site, after edakit
    A concept for publishing the documents as a site with MkDocs Material, modelled on the site of edakit: an assembly
    script, tabs by reader, GitHub's anchors, the colours of the style guide, a strict build on every push and publishing
    from master. It includes a trial build (15 warnings, all links to files that are not documents; three anchors broken
    by MkDocs' own slugs, none with pymdownx's) and the open decision who may read the site, since the repository is
    private.
    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
2026-11-04 Site concept: the three kinds of playing as chapters in the menu
    MP3 albums, radio and Spotify become chapters of their own in the manuals (7, 8 and 9, the later chapters
    renumbered to 10 to 13), and the site shows the manual as pages after a table in the assembly script, so that the
    three stand in the menu of "Use" and of a German tab "Bedienen". A step S0 restructures the manuals before the site.
    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
2026-11-04 The documentation as a site; the manuals with a chapter per kind of playing (0.46.0)
    - scripts/site/assemble.py assembles every document into build/site-src: tabs by reader (Start, Use, Bedienen,
    Set up, Hardware, Develop, Reference, Concepts), the manuals cut into one page per menu entry with MP3 albums,
    Radio and Spotify as pages of their own, links rewritten (pages, images under files/, everything else to GitHub),
    GitHub's anchors with umlauts, German pages marked as German and linked to their English page, a generated table
    of the config keys, concepts marked as plans; scripts/site/build.sh builds it with MkDocs Material --strict
    - docs/site/tinyjukebox.css: plum ink header, berr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
2026-11-04 Test bed: a disconnected box waits for a pass that read the new address
    disconnect() wrote the offline address and waited for one pass of the link. A pass that was already running when
    the file changed still used the old address, so the box could reach the library once more; on a slow runner the
    statistics test then saw "missing: None" instead of "unreachable" (CI, Python 3.12). It waits for a second pass now.
    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
2026-11-04 Administration in English and German; developer documents stay English
    The owner decided: everything for users and administrators in both languages, everything for development in
    English. A new manual for administrators, docs/user/{en,de}/admin.md: setting up a box and the library, updates,
    users and access, backups, logs, configuration, troubleshooting, with links to the developer documents for the
    complete details.
    - the site: tabs "Administer" and "Verwalten" with the administration cut into pages (ADMIN_PAGES, CUT generalises
    the cutting of the manual); the English documents for administrators (configuration, operations, deployment,
    library, deploy/) move to "Reference"; the tab "Se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
2026-11-07 The own log of a box and of the library can be saved as a file (0.47.0)
    Tab "Log", "Save as file" next to "live": the last 5000 entries the page keeps, with level and filter, one
    tab-separated line per entry. The admin manual names the vault of update_library.sh. Page check: the download
    on both pages, the tab in the light and the dark theme.
2026-11-07 TODO.md: the test bed of the slot scripts is built again when they no longer fit (TD-10 done)
2026-11-07 Radio: the start waits for packets the 2.4 GHz WLAN of the box loses, not for the buffer or power saving
2026-11-07 Radio: the WLAN loses its packets while the box pages the switched-off headset every 15 s
2026-11-07 The box pages a switched-off headset only for a minute, then waits for it to connect itself (0.48.0)
    Each page held the radio chip the Pi 3 shares with the WLAN for up to 5 s: every 15 s the WLAN lost its
    packets, and a radio station started after 4-9 s instead of about 1 s. A headset that is connected without
    audio is still completed every 15 s; it needs no page.
2026-11-07 Roadmap: the app of 0.45 verified on a phone (TD-7 done)
    Installed from "Add a phone"; swiped away, tag swapped in the background, another controller and a download
    interrupted by airplane mode as expected. The storage-full and playlist-station rows stay open.
2026-11-07 App: a tag that Android loses for a moment no longer restarts its album; every screen keeps clear of the bars (0.48.1)
    On a Pixel 9a the album flickered and stuttered while the tag lay on the phone, and the buttons at the top lay under
    the status bar (Android 15 draws the app behind it). A lost tag counts as removed only when it is not found again
    within a second, only the watch of the tag found last counts, and TagReader logs found/removed.
2026-11-08 Roadmap: with 0.48.1 the WLAN of the box loses nothing while the headset is switched off
2026-11-08 Spotify: the switch of the speaker stands next to its text, like every other switch of the page
    It was a label.row: .row > input stretched the checkbox to 14rem, so it stood far left of its text, on a phone on a
    line of its own, and was not seen as a switch.
2026-11-08 Version 0.48.4: the switch of the Spotify speaker can be seen
2026-11-08 Spotify: the speaker has a card of its own, "Speaker", that says what it does
    The switch has nothing to do with the account; it stood in the card "Account". Text keys spotify.speaker.* replace
    spotify.account.speaker; the manual names the card.
2026-11-08 "Keep as emergency version" takes the newest proven version of A and B, not only the running one (0.48.5)
    While the running version was still on trial the button refused, though the other slot held a proven version.
    tinyjukebox-slot promote now copies the newest confirmed version of a and b; it still refuses while the fallback
    version itself runs.
2026-11-09 Concept: Spotify advent calendar ready to be implemented – decisions D1–D13, plan A-1 to A-5
    The owner decided the date lock (per calendar, on by default), the days (1–24 December),
    the newest chapter again when a growing playlist has nothing new, and the same rules in the app.
    The rest follows from 0.48.2: a calendar is an entry of its own, a new chapter is found in the
    queue of Soloist, interface version 3.
2026-11-09 Advent calendars on the box: the locked day, a chapter alone, a growing playlist onward (A-2, A-3)
    - LOCKED_DAY: a figure of a later day plays nothing (LED yellow, blinking) and starts by itself when its day
    opens - the date is looked at every minute
    - chapters: the figure of day n plays track n and is finished at its end; "next" finishes it, "back" goes to
    its beginning, never to another day
    - growing: one position for all figures of a calendar; placed while finished, the player goes to the saved
    chapter and starts at the next track if the playlist itself has one (Soloist's queue, not autoplay) -
    otherwise the saved chapter plays again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
2026-11-09 Two buttons for the emergency version: "Keep A …" and "Keep B …" name the version of their slot (0.49.1)
    tinyjukebox-slot promote a|b copies the confirmed version of that slot; promote alone keeps the newest confirmed
    version of both, as the installer asks for it. A button is greyed out while its version is on probation, is the
    emergency version already, or the emergency version runs.
